sneumeister/Garage2/Pictures/README.md

# Bilder der aktuellen Installation
## Übersicht
Lochrasterplatine mit ESP32U-Board und Relais im Kunststoffgehäuse an der Garagenwand.
Der rechte Kabelkanal führt zum Winkelgeber (Spannungsteiler-Poti).
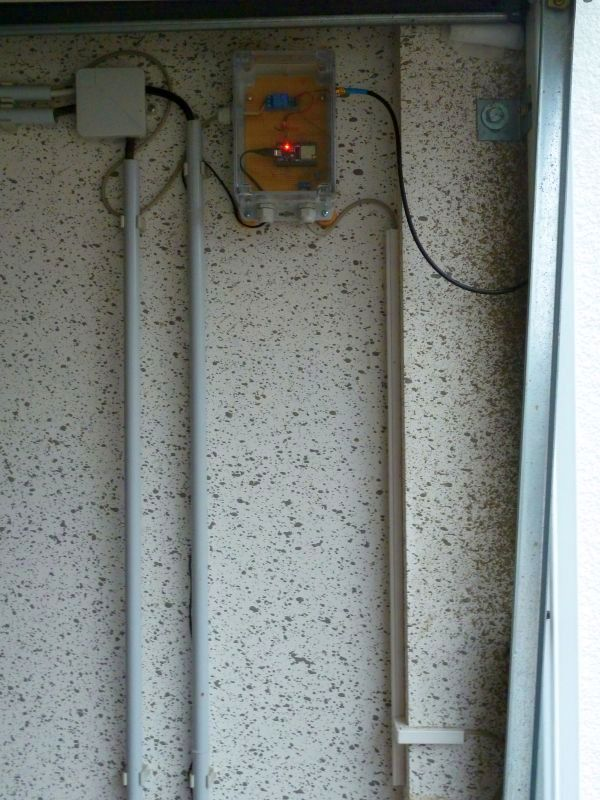
[picture p9: Pictures/01_Uebersicht.jpg]
Übersicht


## Detailansicht Box
Rechtes schwarzes Kabel ist führt zur externen WLAN-Antenne vor dem Metall-Tor.
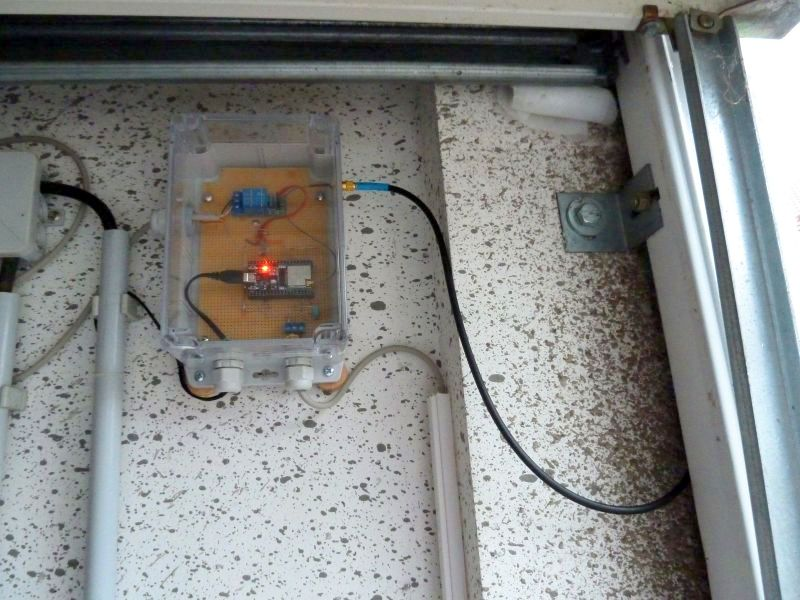
[picture p10: Pictures/02_box.jpg]
Box


Wie man 2,4Ghz-WLAN-Antenne selber machen kann, zeigt folgendes [YouTube-Video](https://www.youtube.com/watch?v=bs8hvXGJdhM)


## Detailansicht Platine
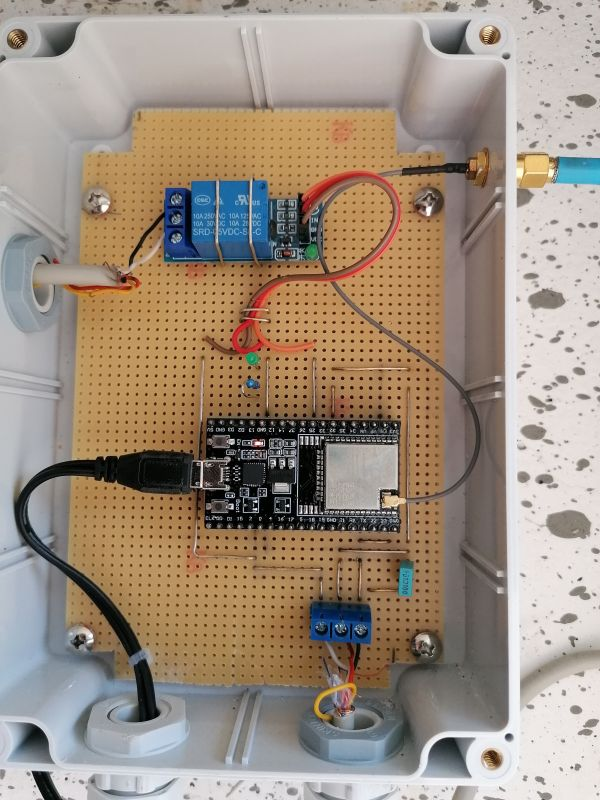
[picture p11: Pictures/07_Platine_in_Box.jpg]
Platine_in_Box


##Winkelgebergehäuse
3D-Gedrucktes Gehäuse; CAD und STL-Daten im Verzeichnis [Winkelgeber-Gehaeuse](../Winkelgeber-Gehaeuse).
Der quadratische Mitnehmer-Block auf der Poti-Welle läuft locker im U-Profil der Tor-Aufhängung.
Das Gehäuse ist an die Wand geklebt.
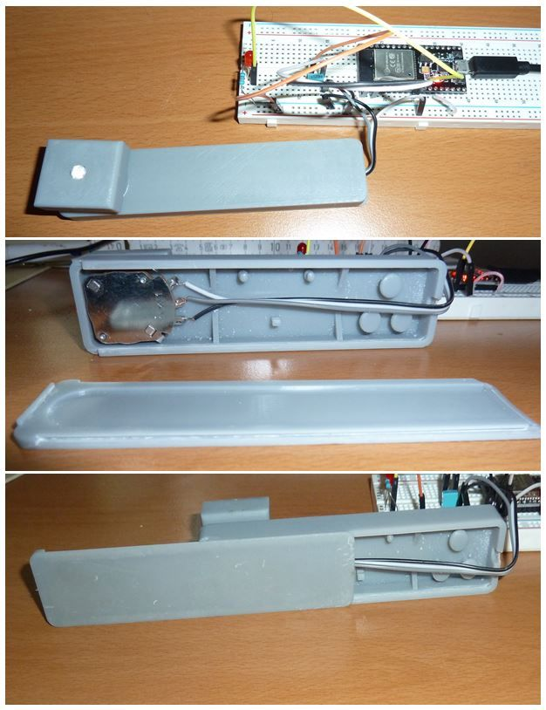
[picture p12: Pictures/03_Winkelgeber1.jpg]
Winkelgeber-Bild1
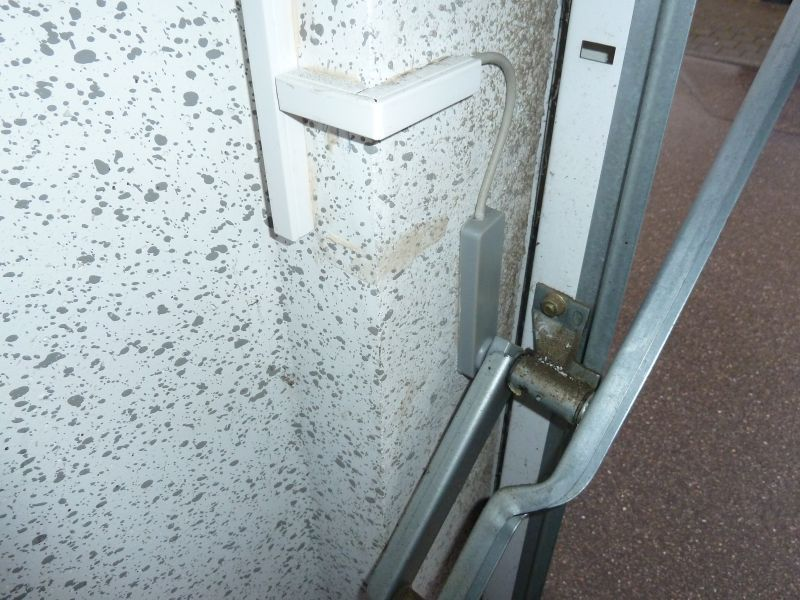
[picture p13: Pictures/04_winkelgeber2.jpg]
Winkelgeber-Bild2


## Pin-Out meines ESP32U
"U" = externer Antennenanschluß.

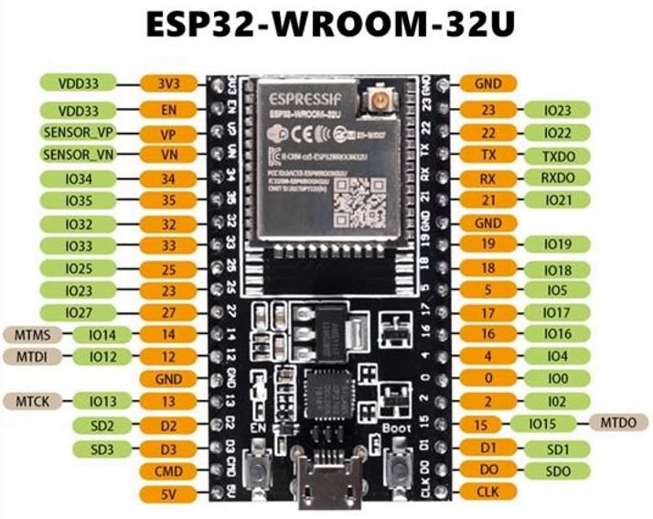
[picture p14: Pictures/05_ESP32U-pinout.jpg]
Pinout-ESP32U


## Schaltbild
Das Schaltbild, sowie eine kleine Stückliste in Verzeichnis [Schematics](../Schematics).

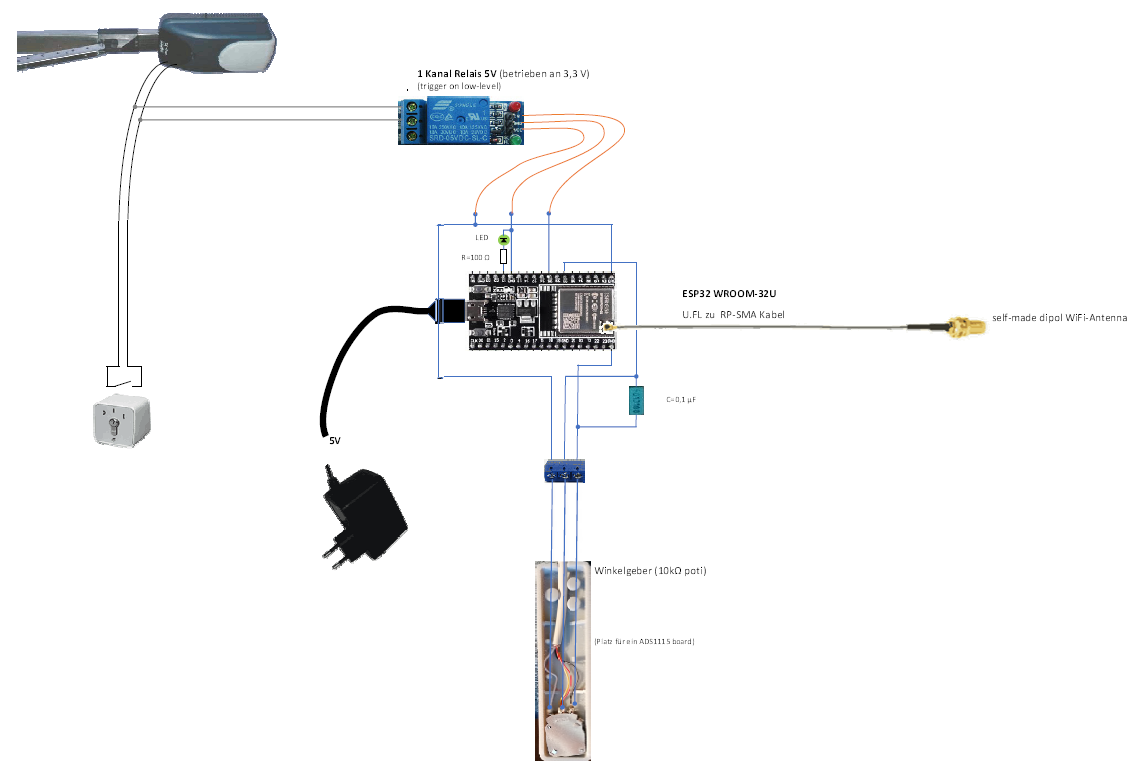
[picture p15: Pictures/06_Schematics.png]
Schaltbild
