sneumeister/Garage2/Winkelgeber-Gehaeuse/README.md

# CAD Modell
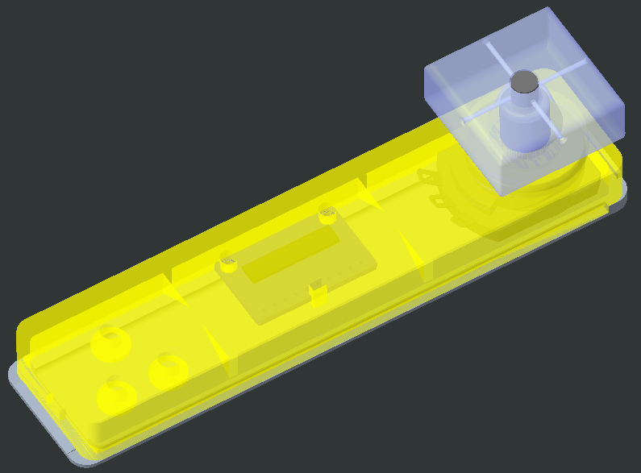
[picture p16: Winkelgeber-Gehaeuse/Winkelgeber-Gehaeuse.png]
CAD-Winkelgeber-Gehäuse

# Reales Gehäuse
Real-Winkelgeber-Gehäuse
