sneumeister/Garage2/misc/Schematics.png

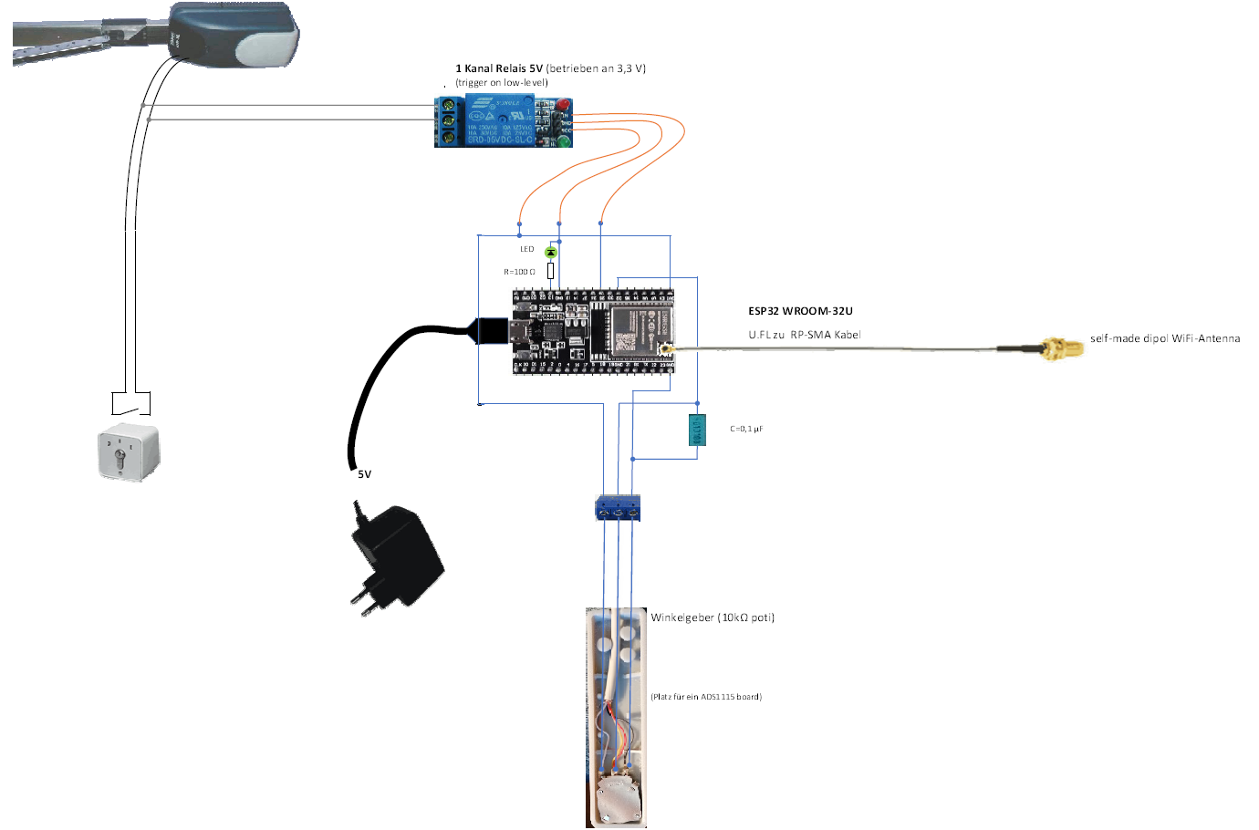
misc/Schematics.png
