sneumeister/Garage2/misc/stecker.png

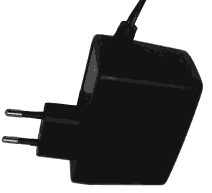
misc/stecker.png
