sneumeister/Garage2/Pictures/configscreen.gif

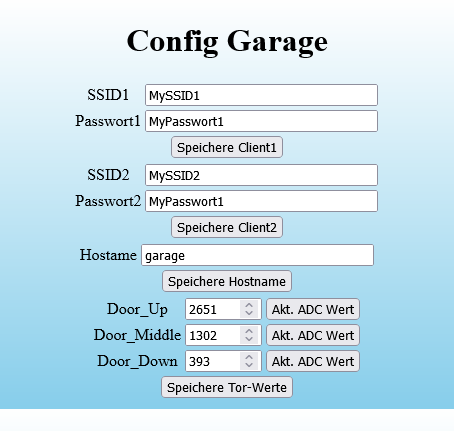
Pictures/configscreen.gif
