sneumeister/Garage2/Source/Garage2/data/button.png

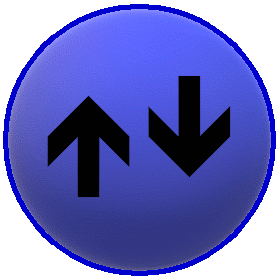
Source/Garage2/data/button.png
