sneumeister/Garage2/Source/Garage2/data/button_lost.png

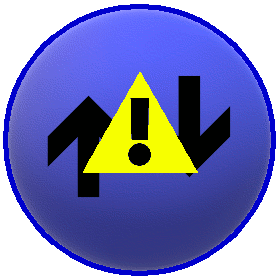
Source/Garage2/data/button_lost.png
