sneumeister/Garage2/Source/Garage2/data/button_push.png

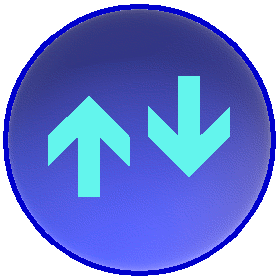
Source/Garage2/data/button_push.png
