sneumeister/Garage2/Source/Garage2/data/garage0.png

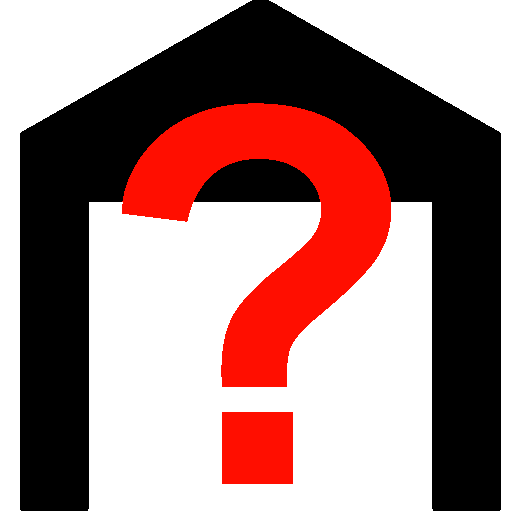
Source/Garage2/data/garage0.png
