sneumeister/Garage2/Schematics/BOM.pdf

Stückliste / BOM

Anz. | Beschreibung | Bem.
1 | ESP32 WROOM-32U | auf ebay (https://www.ebay.de/itm/233643497512)
1 | 1 Kanal Relais 5V/230V (geht auch mit 3,3V .. Active LOW) | auf ebay (https://www.ebay.de/itm/252713915632)
1 | U.FL auf RP-SMA Adapterkabel | auf ebay (https://www.ebay.de/itm/333549976413)
1 | Drehpotentiometer, Mono, 10 kOhm, linear, 6 mm | Reichelt (https://www.reichelt.de/drehpotentiometer-mono-10-kohm-linear-6-mm-po6m-lin-10k-p88207.html?trstct=pos_6&nbc=1)
1 | DIY WLAN-Antenne | Dipole Antenna for 2 4 ghz Wifi - YouTube (https://www.youtube.com/watch?v=bs8hvXGJdhM)
1 | Punkt-Streifenrasterplatine, Hartpapier, 160x100mm | Reichelt (https://www.reichelt.de/punkt-streifenrasterplati-hartpapier-160x100mm-h25ps160-p23953.html?&nbc=1)
1 | RM 5,08 Printklemmen 3-polig | eBay (https://www.ebay.de/itm/303366049631)
3 | PG-Verschraubung
1 | RND 455-00243 - Kunststoffgehäuse 121x171x80mm Hellgrau | datasheet (https://www.distrelec.de/Web/Downloads/_t/ds/RND_455-00243_30064464_mcd_eng_tds.pdf)
1 | Netzteil 5V - 2,5A - Micro-USB | Reichelt (https://www.reichelt.de/raspberry-pi-netzteil-5-v-2-5-a-micro-usb-schwarz-nt-musb-25-sw-p167078.html?nbc=1)
