sneumeister/Garage2/(list of files, cad)

Other CAD files:
Winkelgeber-Gehaeuse/adc-platine.prt
Winkelgeber-Gehaeuse/gehaeuse1.prt
Winkelgeber-Gehaeuse/gehaeuse2.prt
Winkelgeber-Gehaeuse/mitnehmer.prt
Winkelgeber-Gehaeuse/poti.prt
