sneumeister/Garage2/(commit log)

2022-02-21 Picture Verzeichnis und README.md zugefügt
    Picture Verzeichnis und README.md zugefügt
2022-03-06 Ordner-Struktur geändert
    [PCB1.xlsx]
2022-03-06 Winkelgeber-Gehäuse CAD/STL zugefügt
    [adc-platine.prt, gehaeuse1.prt, gehaeuse2.prt, mitnehmer.prt, poti.prt]
2022-03-06 BOM + CAD/STL Daten zugefügt und ein paar Bilder
2022-03-26 "Source" Pfad angepasst
    Unterverzeichnung "Gargae2", damit direkt mit der ArduinoIDE gearbeitet werden kann.
2022-03-27 #define Config default Values
    Update config.h und config.cpp
2022-04-10 Software korrekturen
    Hardware Initialisierung (Pins + ADC) zugefügt; Config.html um einen "Neustart" button ergänzt.
2022-04-13 Kommentare korrigiert
    Keine Inhaltlichen Änderungen
    [Config.cpp, Garage2.ino, _sketchversion.h]
2022-11-19 signal-LED via independent task
    waitms() replaced by vTaskDelay(),
    littleHelpers.cpp/h deleted,
    clean-up debug #define's,
    signal-LED operated by independet task
    [Garage2.ino, _sketchversion.h, debug.h, hardwareRelated.cpp, hardwareRelated.h, myArduinoOTA.h, mywifi.cpp, mywifi.h]
2022-11-20 signalLED message as chr* string
    Send msg string to queue,
    some correction,
    wifi.cpp/wifi.h DEBUG info corrected
    [Garage2.ino, _sketchversion.h, hardwareRelated.cpp, hardwareRelated.h, mywifi.cpp, mywifi.h]
2023-08-08 Add self-made-antenna
    Add self-made-antenna
2023-08-08 Update README.md
    Add pic of selfmade antenna
2026-09-11 build: add pioarduino PlatformIO config with Arduino framework
2026-09-12 refactor: migrate ArduinoJson 7 and adc_oneshot, clean warnings
2026-09-12 fix: harden signal-led queue and fix include/ssid checks
    [Garage2.ino, hardwareRelated.cpp, hardwareRelated.h, myArduinoOTA.h, mywifi.cpp, mywifi.h]
2026-09-12 fix(wifi): defer SoftAP stop with 5min grace after STA connect
    [Garage2.ino, mywifi.cpp, mywifi.h]
2026-09-13 docs: document pioarduino and Arduino IDE 2.x builds
